ekiwi/led-table/README.md

8x8 RGB LED Table
=================

This project aimed at creating a 8x8 RGB LED Table that
features two controlers:
* a Colorduino from iTead Studio inside the table
* and a custom Main Board featuring an atmega644
  for the control panel
