ekiwi/led-table/pcbs/interface.brd

## EAGLE design pcbs/interface.brd (2012-09-30)

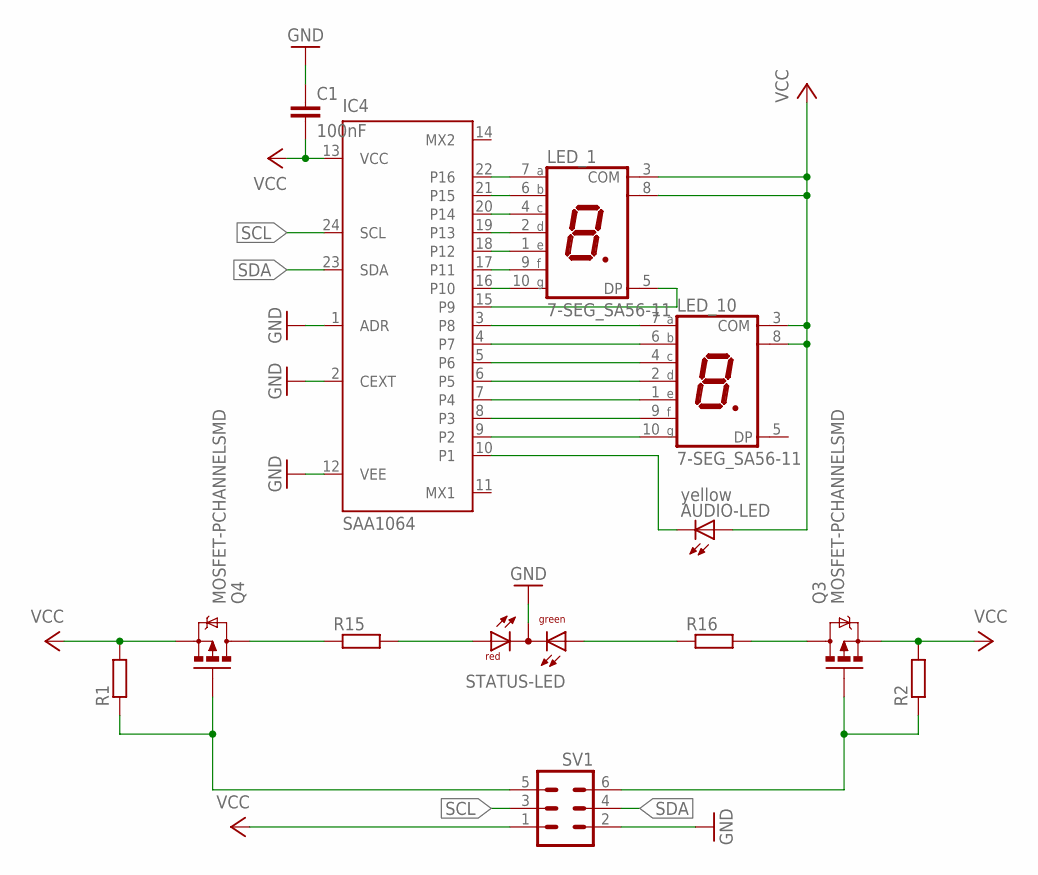
[picture p1: schematic interface.sch, sheet 1]

Parts:
AUDIO-LED: yellow; LED10MM
C1: 100nF; C1206
IC4: SAA1064; DIL24-6
LED_1, LED_10: 7-SEG_SA56-11; SA56-11
Q3, Q4: MOSFET-PCHANNELSMD; SOT23-3
R1, R2, R15, R16: R-EU_R1206; R1206
STATUS-LED: DUOLED-RG-C; DUOLED-C-5MM
SV1: ML6SMD2; ML6_SMD2

Connections:
GND: C1.1, IC4.1 (ADR), IC4.2 (CEXT), IC4.12 (VEE), STATUS-LED.C, SV1.2
unnamed: IC4.17 (P11), LED_1.9 (F)
unnamed: IC4.19 (P13), LED_1.2 (D)
unnamed: IC4.21 (P15), LED_1.6 (B)
unnamed: IC4.22 (P16), LED_1.7 (A)
unnamed: IC4.20 (P14), LED_1.4 (C)
unnamed: IC4.18 (P12), LED_1.1 (E)
unnamed: IC4.16 (P10), LED_1.10 (G)
unnamed: IC4.15 (P9), LED_1.5 (DP)
unnamed: AUDIO-LED.K (C), IC4.10 (P1)
unnamed: IC4.3 (P8), LED_10.7 (A)
unnamed: IC4.4 (P7), LED_10.6 (B)
unnamed: IC4.5 (P6), LED_10.4 (C)
unnamed: IC4.6 (P5), LED_10.2 (D)
unnamed: IC4.7 (P4), LED_10.1 (E)
unnamed: IC4.8 (P3), LED_10.9 (F)
unnamed: IC4.9 (P2), LED_10.10 (G)
unnamed: Q4.3 (D), R15.1
unnamed: Q3.3 (D), R16.2
unnamed: R15.2, STATUS-LED.AR
unnamed: R16.1, STATUS-LED.AX (AG)
SCL: IC4.24 (SCL), SV1.3
SDA: IC4.23 (SDA), SV1.4
STATUS_GREEN: Q3.1 (G), R2.1, SV1.6
STATUS_RED: Q4.1 (G), R1.1, SV1.5
VCC: AUDIO-LED.A, C1.2, IC4.13 (VCC), LED_1.3 (COM), LED_1.8 (COM), LED_10.3 (COM), LED_10.8 (COM), Q3.2 (S), Q4.2 (S), R1.2, R2.2, SV1.1

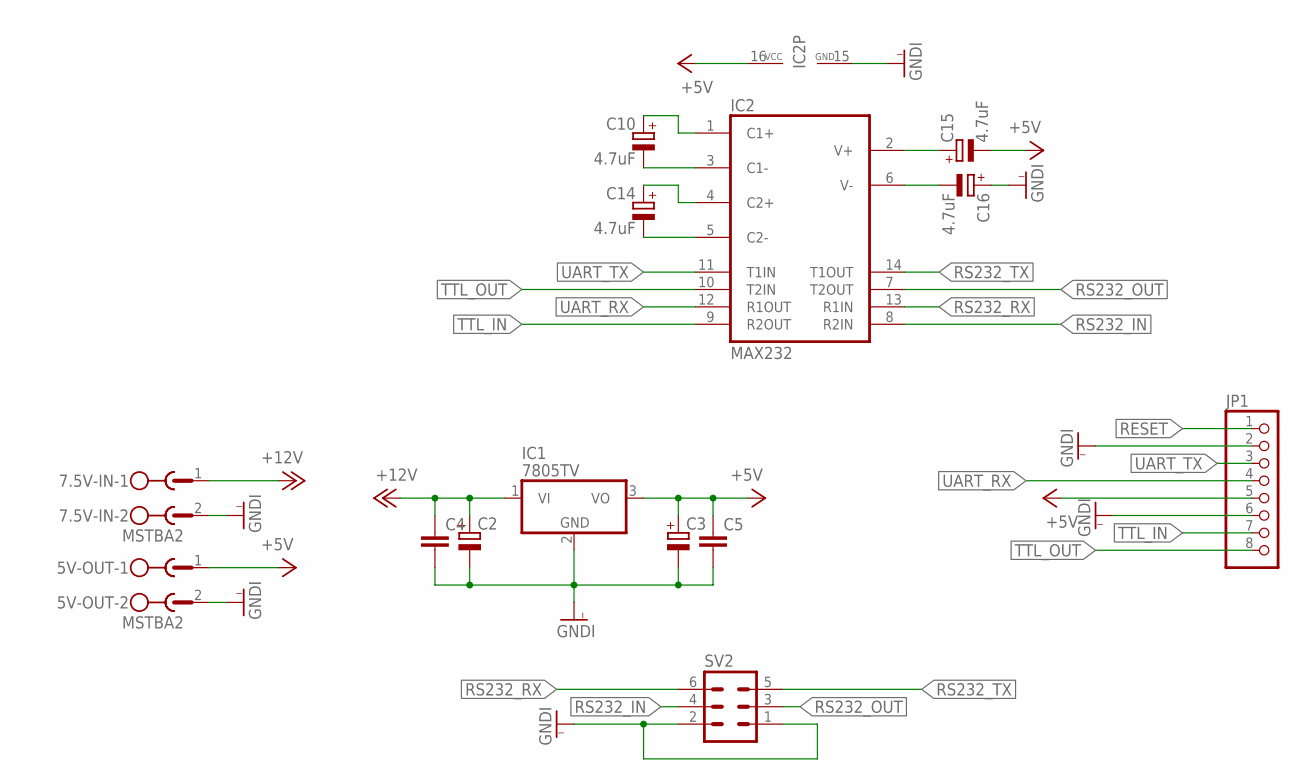
[picture p2: schematic interface.sch, sheet 2]

Parts:
5V-OUT, 7.5V-IN: MSTBA2
C2, C3: CPOL-EUE5-10.5; E5-10,5
C4, C5: C-EUC1206; C1206
C10, C14, C15, C16: 4.7uF; E2-5
IC1: 7805TV; TO220V
IC2: MAX232; DIL16
JP1: PINHD-1X8/90; 1X08/90
SV2: ML6

Connections:
+5V: 5V-OUT.1, C3.+, C5.1, C15.-, IC1.3 (VO), IC2.16 (VCC), JP1.5
+12V: 7.5V-IN.1, C2.+, C4.1, IC1.1 (VI)
GNDI: 5V-OUT.2, 7.5V-IN.2, C2.-, C3.-, C4.2, C5.2, C16.+, IC1.2 (GND), IC2.15 (GND), JP1.2, JP1.6, SV2.1, SV2.2
unnamed: C14.+, IC2.4 (C2+)
unnamed: C14.-, IC2.5 (C2-)
unnamed: C10.-, IC2.3 (C1-)
unnamed: C10.+, IC2.1 (C1+)
unnamed: C16.-, IC2.6 (V-)
unnamed: C15.+, IC2.2 (V+)
RESET: JP1.1
RS232_IN: IC2.8 (R2IN), SV2.4
RS232_OUT: IC2.7 (T2OUT), SV2.3
RS232_RX: IC2.13 (R1IN), SV2.6
RS232_TX: IC2.14 (T1OUT), SV2.5
TTL_IN: IC2.9 (R2OUT), JP1.7
TTL_OUT: IC2.10 (T2IN), JP1.8
UART_RX: IC2.12 (R1OUT), JP1.4
UART_TX: IC2.11 (T1IN), JP1.3

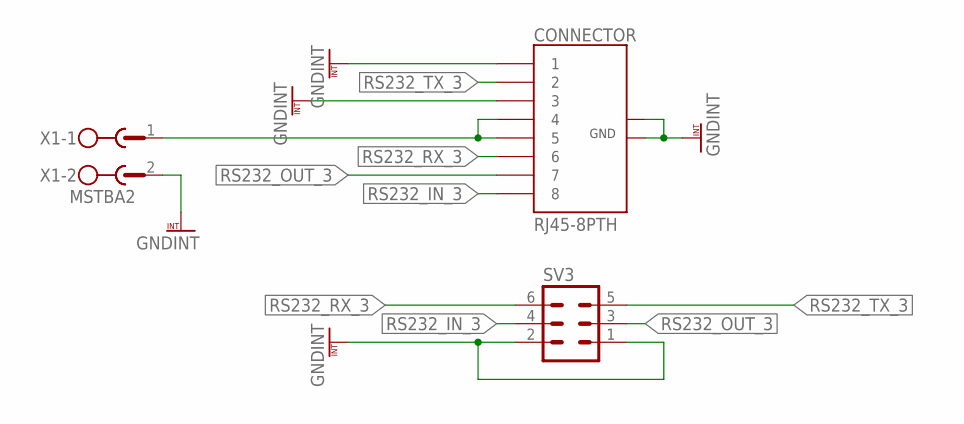
[picture p3: schematic interface.sch, sheet 3]

Parts:
CONNECTOR: RJ45-8PTH; RJ45-8
SV3: ML6
X1: MSTBA2

Connections:
GNDINT: CONNECTOR.1, CONNECTOR.3, CONNECTOR.GND_1, CONNECTOR.GND_2, SV3.1, SV3.2, X1.2
RS232_IN_3: CONNECTOR.8, SV3.4
RS232_OUT_3: CONNECTOR.7, SV3.3
RS232_RX_3: CONNECTOR.6, SV3.6
RS232_TX_3: CONNECTOR.2, SV3.5
V_BAT: CONNECTOR.4, CONNECTOR.5, X1.1

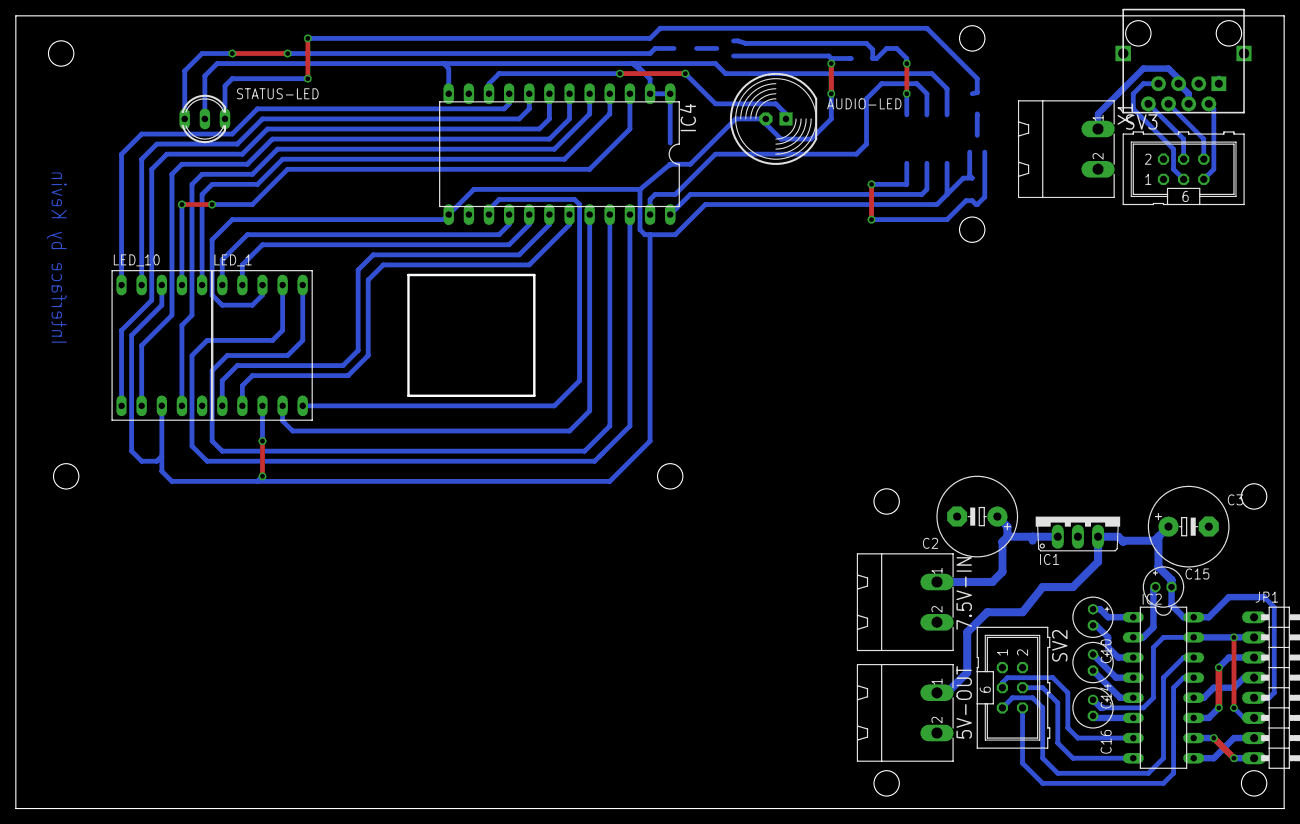
[picture p4: board interface.brd from above]

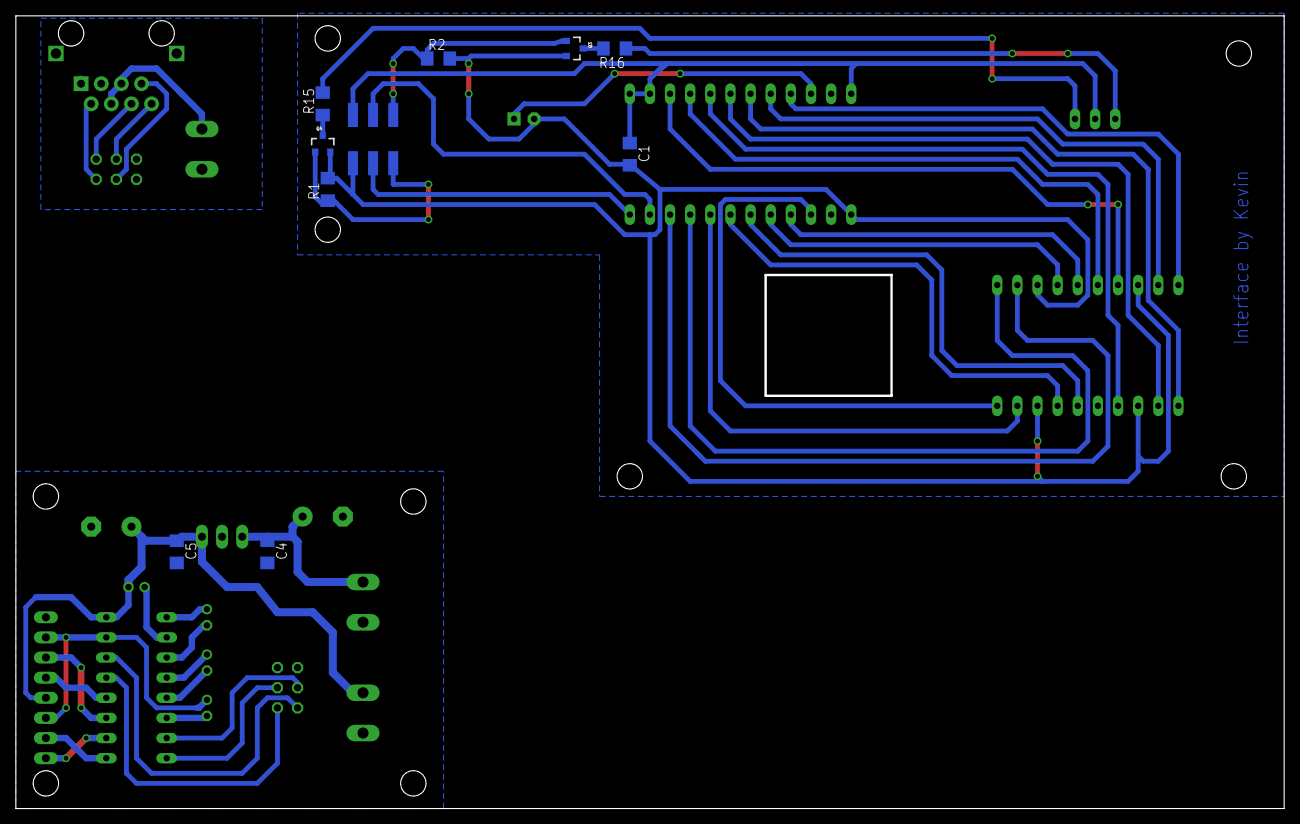
[picture p5: board interface.brd from below]

Board: 2 copper layers, 160.0 x 100.0 mm, 30 parts (10 on the bottom side), 49 nets.
