ekiwi/led-table/pcbs/mainboard.brd

## EAGLE design pcbs/mainboard.brd (2012-09-30)

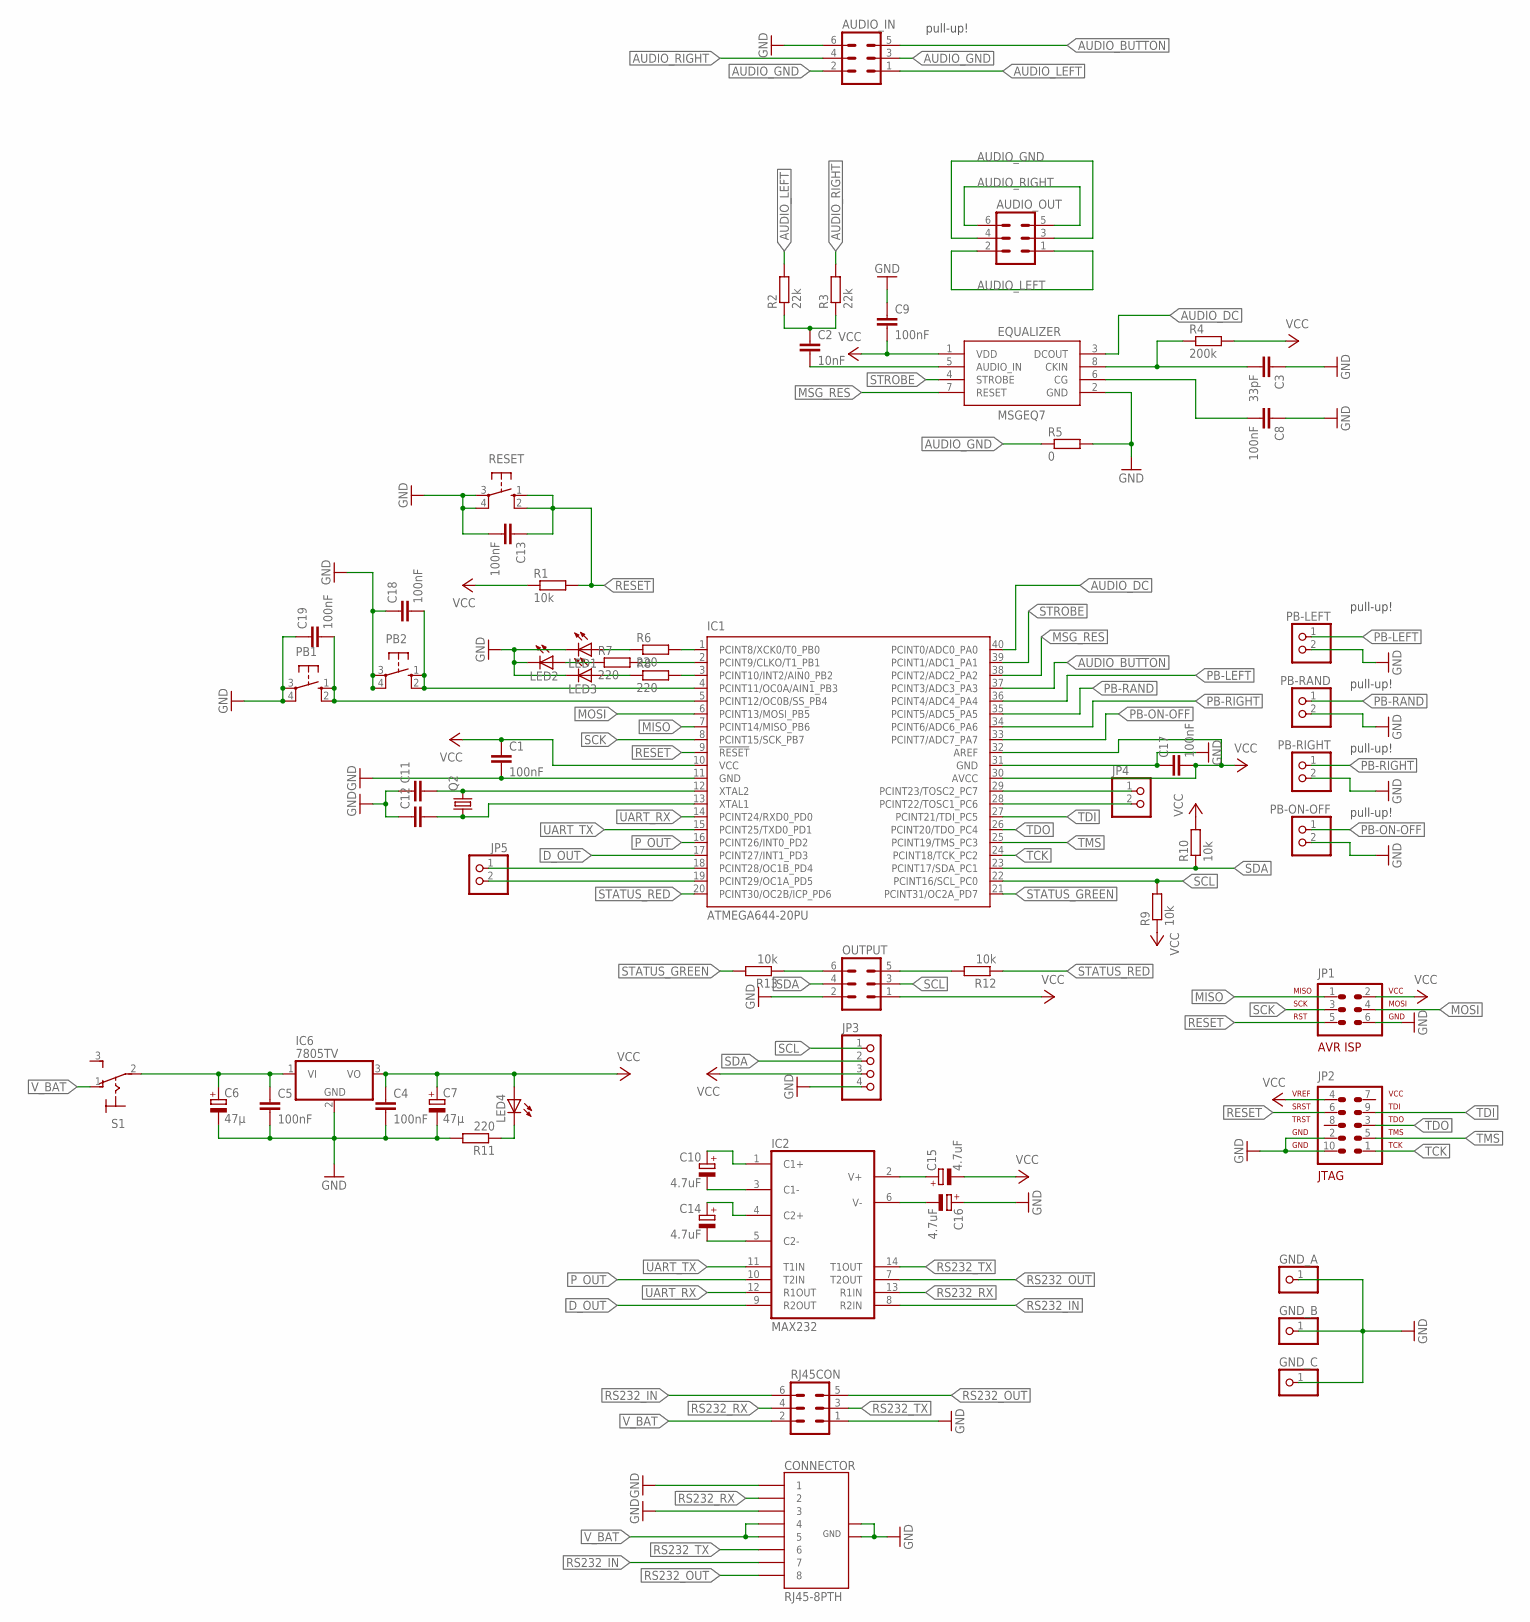
[picture p6: schematic mainboard.sch]

Parts:
AUDIO_IN: ML6
AUDIO_OUT: ML6
C1, C4, C5, C8, C9, C13, C17, C18, C19: 100nF; C1206
C2: 10nF; C1206
C3: 33pF; C1206
C6, C7: 47µ; E2,5-6
C10, C14, C15, C16: 4.7uF; E2-5
C11, C12: C-EUC1206; C1206
CONNECTOR: RJ45-8PTH; RJ45-8
EQUALIZER: MSGEQ7; DIL-08
GND_A: PINHD-1X1; 1X01
GND_B: PINHD-1X1; 1X01
GND_C: PINHD-1X1; 1X01
IC1: ATMEGA644-20PU; DIL40
IC2: MAX232; DIL16
IC6: 7805TV; TO220V
JP1: AVR-ISP-6VERT; AVR-ISP-6
JP2: AVR-JTAG-10
JP3: PINHD-1X4; 1X04
JP4, JP5: PINHD-1X2; 1X02
LED1, LED2, LED3, LED4: LED5MM
OUTPUT: ML6
PB1, PB2: 10-XX; B3F-10XX; MPN B3F-1000
PB-LEFT: PINHD-1X2; 1X02
PB-ON-OFF: PINHD-1X2; 1X02
PB-RAND: PINHD-1X2; 1X02
PB-RIGHT: PINHD-1X2; 1X02
Q2: CRYSTALHC49S; HC49/S
R1, R9: 10k; 0207/10
R2, R3: 22k; 0207/10
R4: 200k; 0207/10
R5: 0; M1206
R6, R7, R8, R11: 220; 0207/10
R10, R13: 10k; 0207/12
R12: 10k; 0207/15
RESET: 10-XX; B3F-10XX
RJ45CON: ML6
S1: M9040P

Connections:
AUDIO_BUTTON: AUDIO_IN.5, IC1.37 (PCINT3/ADC3_PA3)
AUDIO_DC: EQUALIZER.3 (DCOUT), IC1.40 (PCINT0/ADC0_PA0)
AUDIO_GND: AUDIO_IN.2, AUDIO_IN.3, AUDIO_OUT.3, AUDIO_OUT.4, R5.1
AUDIO_LEFT: AUDIO_IN.1, AUDIO_OUT.1, AUDIO_OUT.2, R2.2
AUDIO_RIGHT: AUDIO_IN.4, AUDIO_OUT.5, AUDIO_OUT.6, R3.2
D_OUT: IC1.17 (PCINT27/INT1_PD3), IC2.9 (R2OUT)
FJKSABFJSD: C5.1, C6.+, IC6.1 (VI), S1.2
GND: AUDIO_IN.6, C1.2, C3.1, C4.2, C5.2, C6.-, C7.-, C8.1, C9.1, C11.1, C12.1, C13.2, C16.+, C17.1, C18.1, C19.1, CONNECTOR.1, CONNECTOR.3, CONNECTOR.GND_1, CONNECTOR.GND_2, EQUALIZER.2 (GND), GND_A.1, GND_B.1, GND_C.1, IC1.11 (GND), IC1.31 (GND), IC2.15 (GND), IC6.2 (GND), JP1.6, JP2.2, JP2.10, JP3.4, LED1.K (C), LED2.K (C), LED3.K (C), OUTPUT.2, PB1.3, PB1.4 (P1), PB2.3, PB2.4 (P1), PB-LEFT.2, PB-ON-OFF.2, PB-RAND.2, PB-RIGHT.2, R5.2, R11.2, RESET.3, RESET.4 (P1), RJ45CON.1
MISO: IC1.7 (PCINT14/MISO_PB6), JP1.1
MOSI: IC1.6 (PCINT13/MOSI_PB5), JP1.4
MSG_RES: EQUALIZER.7 (RESET), IC1.38 (PCINT2/ADC2_PA2)
unnamed: C2.2, EQUALIZER.5 (AUDIO_IN)
unnamed: C2.1, R2.1, R3.1
unnamed: C3.2, EQUALIZER.8 (CKIN), R4.1
unnamed: C14.+, IC2.4 (C2+)
unnamed: C8.2, EQUALIZER.6 (CG)
unnamed: C14.-, IC2.5 (C2-)
unnamed: C10.-, IC2.3 (C1-)
unnamed: C10.+, IC2.1 (C1+)
unnamed: C16.-, IC2.6 (V-)
unnamed: C15.+, IC2.2 (V+)
unnamed: LED1.A, R6.1
unnamed: IC1.1 (PCINT8/XCK0/T0_PB0), R6.2
unnamed: IC1.2 (PCINT9/CLKO/T1_PB1), R7.2
unnamed: LED2.A, R7.1
unnamed: IC1.3 (PCINT10/INT2/AIN0_PB2), R8.2
unnamed: C11.2, IC1.12 (XTAL2), Q2.2
unnamed: C12.2, IC1.13 (XTAL1), Q2.1
unnamed: LED3.A, R8.1
unnamed: LED4.K (C), R11.1
unnamed: C18.2, IC1.4 (PCINT11/OC0A/AIN1_PB3), PB2.1 (S), PB2.2 (S1)
unnamed: IC1.28 (PCINT22/TOSC1_PC6), JP4.2
unnamed: IC1.29 (PCINT23/TOSC2_PC7), JP4.1
unnamed: OUTPUT.5, R12.2
unnamed: C19.2, IC1.5 (PCINT12/OC0B/SS_PB4), PB1.1 (S), PB1.2 (S1)
unnamed: OUTPUT.6, R13.1
unnamed: IC1.18 (PCINT28/OC1B_PD4), JP5.1
unnamed: IC1.19 (PCINT29/OC1A_PD5), JP5.2
PB-LEFT: IC1.36 (PCINT4/ADC4_PA4), PB-LEFT.1
PB-ON-OFF: IC1.33 (PCINT7/ADC7_PA7), PB-ON-OFF.1
PB-RAND: IC1.35 (PCINT5/ADC5_PA5), PB-RAND.1
PB-RIGHT: IC1.34 (PCINT6/ADC6_PA6), PB-RIGHT.1
P_OUT: IC1.16 (PCINT26/INT0_PD2), IC2.10 (T2IN)
RESET: C13.1, IC1.9 (!RESET), JP1.5, JP2.6, R1.2, RESET.1 (S), RESET.2 (S1)
RS232_IN: CONNECTOR.7, IC2.8 (R2IN), RJ45CON.6
RS232_OUT: CONNECTOR.8, IC2.7 (T2OUT), RJ45CON.5
RS232_RX: CONNECTOR.2, IC2.13 (R1IN), RJ45CON.4
RS232_TX: CONNECTOR.6, IC2.14 (T1OUT), RJ45CON.3
SCK: IC1.8 (PCINT15/SCK_PB7), JP1.3
SCL: IC1.22 (PCINT16/SCL_PC0), JP3.1, OUTPUT.3, R9.2
SDA: IC1.23 (PCINT17/SDA_PC1), JP3.2, OUTPUT.4, R10.1
STATUS_GREEN: IC1.21 (PCINT31/OC2A_PD7), R13.2
STATUS_RED: IC1.20 (PCINT30/OC2B/ICP_PD6), R12.1
STROBE: EQUALIZER.4 (STROBE), IC1.39 (PCINT1/ADC1_PA1)
TCK: IC1.24 (PCINT18/TCK_PC2), JP2.1
TDI: IC1.27 (PCINT21/TDI_PC5), JP2.9
TDO: IC1.26 (PCINT20/TDO_PC4), JP2.3
TMS: IC1.25 (PCINT19/TMS_PC3), JP2.5
UART_RX: IC1.14 (PCINT24/RXD0_PD0), IC2.12 (R1OUT)
UART_TX: IC1.15 (PCINT25/TXD0_PD1), IC2.11 (T1IN)
VCC: C1.1, C4.1, C7.+, C9.2, C15.-, C17.2, EQUALIZER.1 (VDD), IC1.10 (VCC), IC1.30 (AVCC), IC1.32 (AREF), IC2.16 (VCC), IC6.3 (VO), JP1.2, JP2.4, JP3.3, LED4.A, OUTPUT.1, R1.1, R4.2, R9.1, R10.2
V_BAT: CONNECTOR.4, CONNECTOR.5, RJ45CON.2, S1.1 (O)

Notes on the sheet:
pull-up!

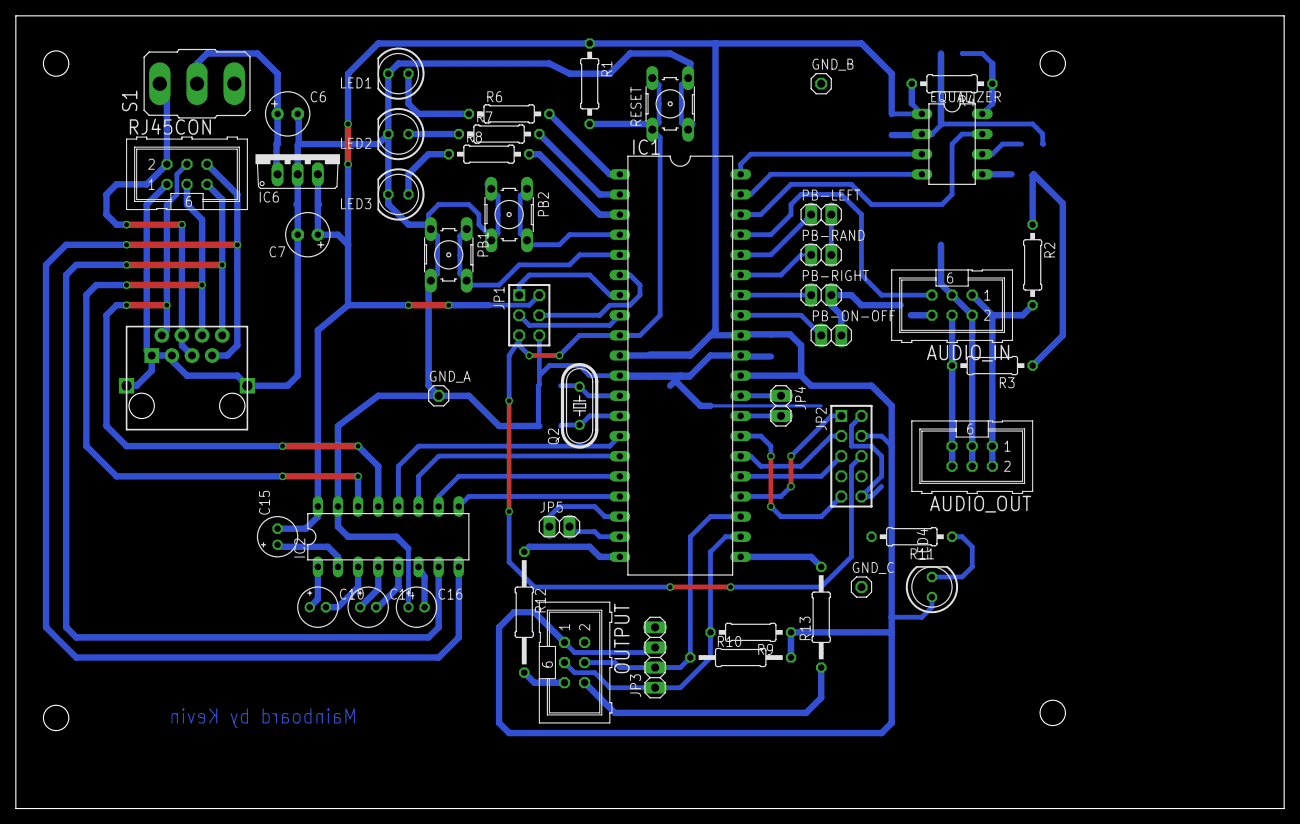
[picture p7: board mainboard.brd from above]

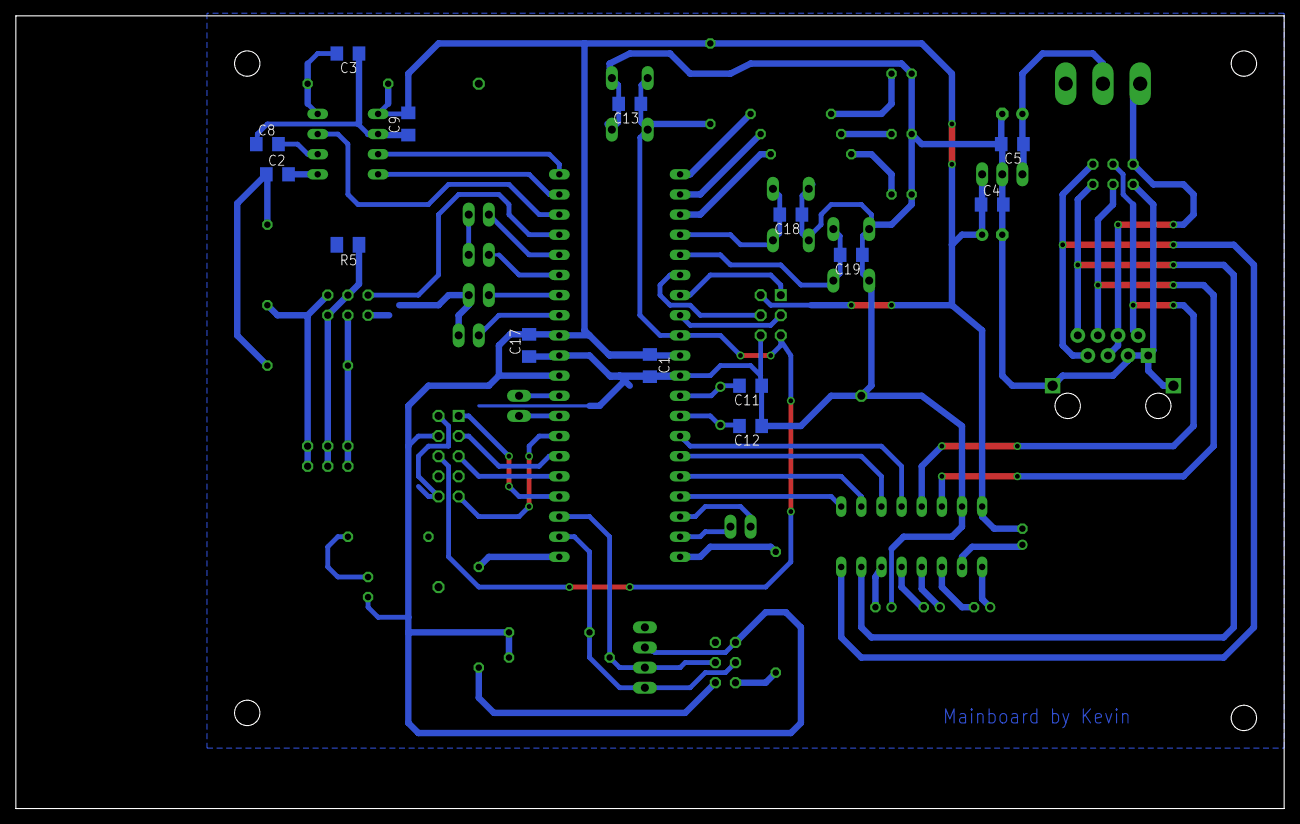
[picture p8: board mainboard.brd from below]

Board: 2 copper layers, 160.0 x 100.0 mm, 62 parts (14 on the bottom side), 62 nets.
